peppapighs/HE8/HE8/HE8.kicad_pcb

## KiCad design HE8/HE8.kicad_pcb (2024-11-02)

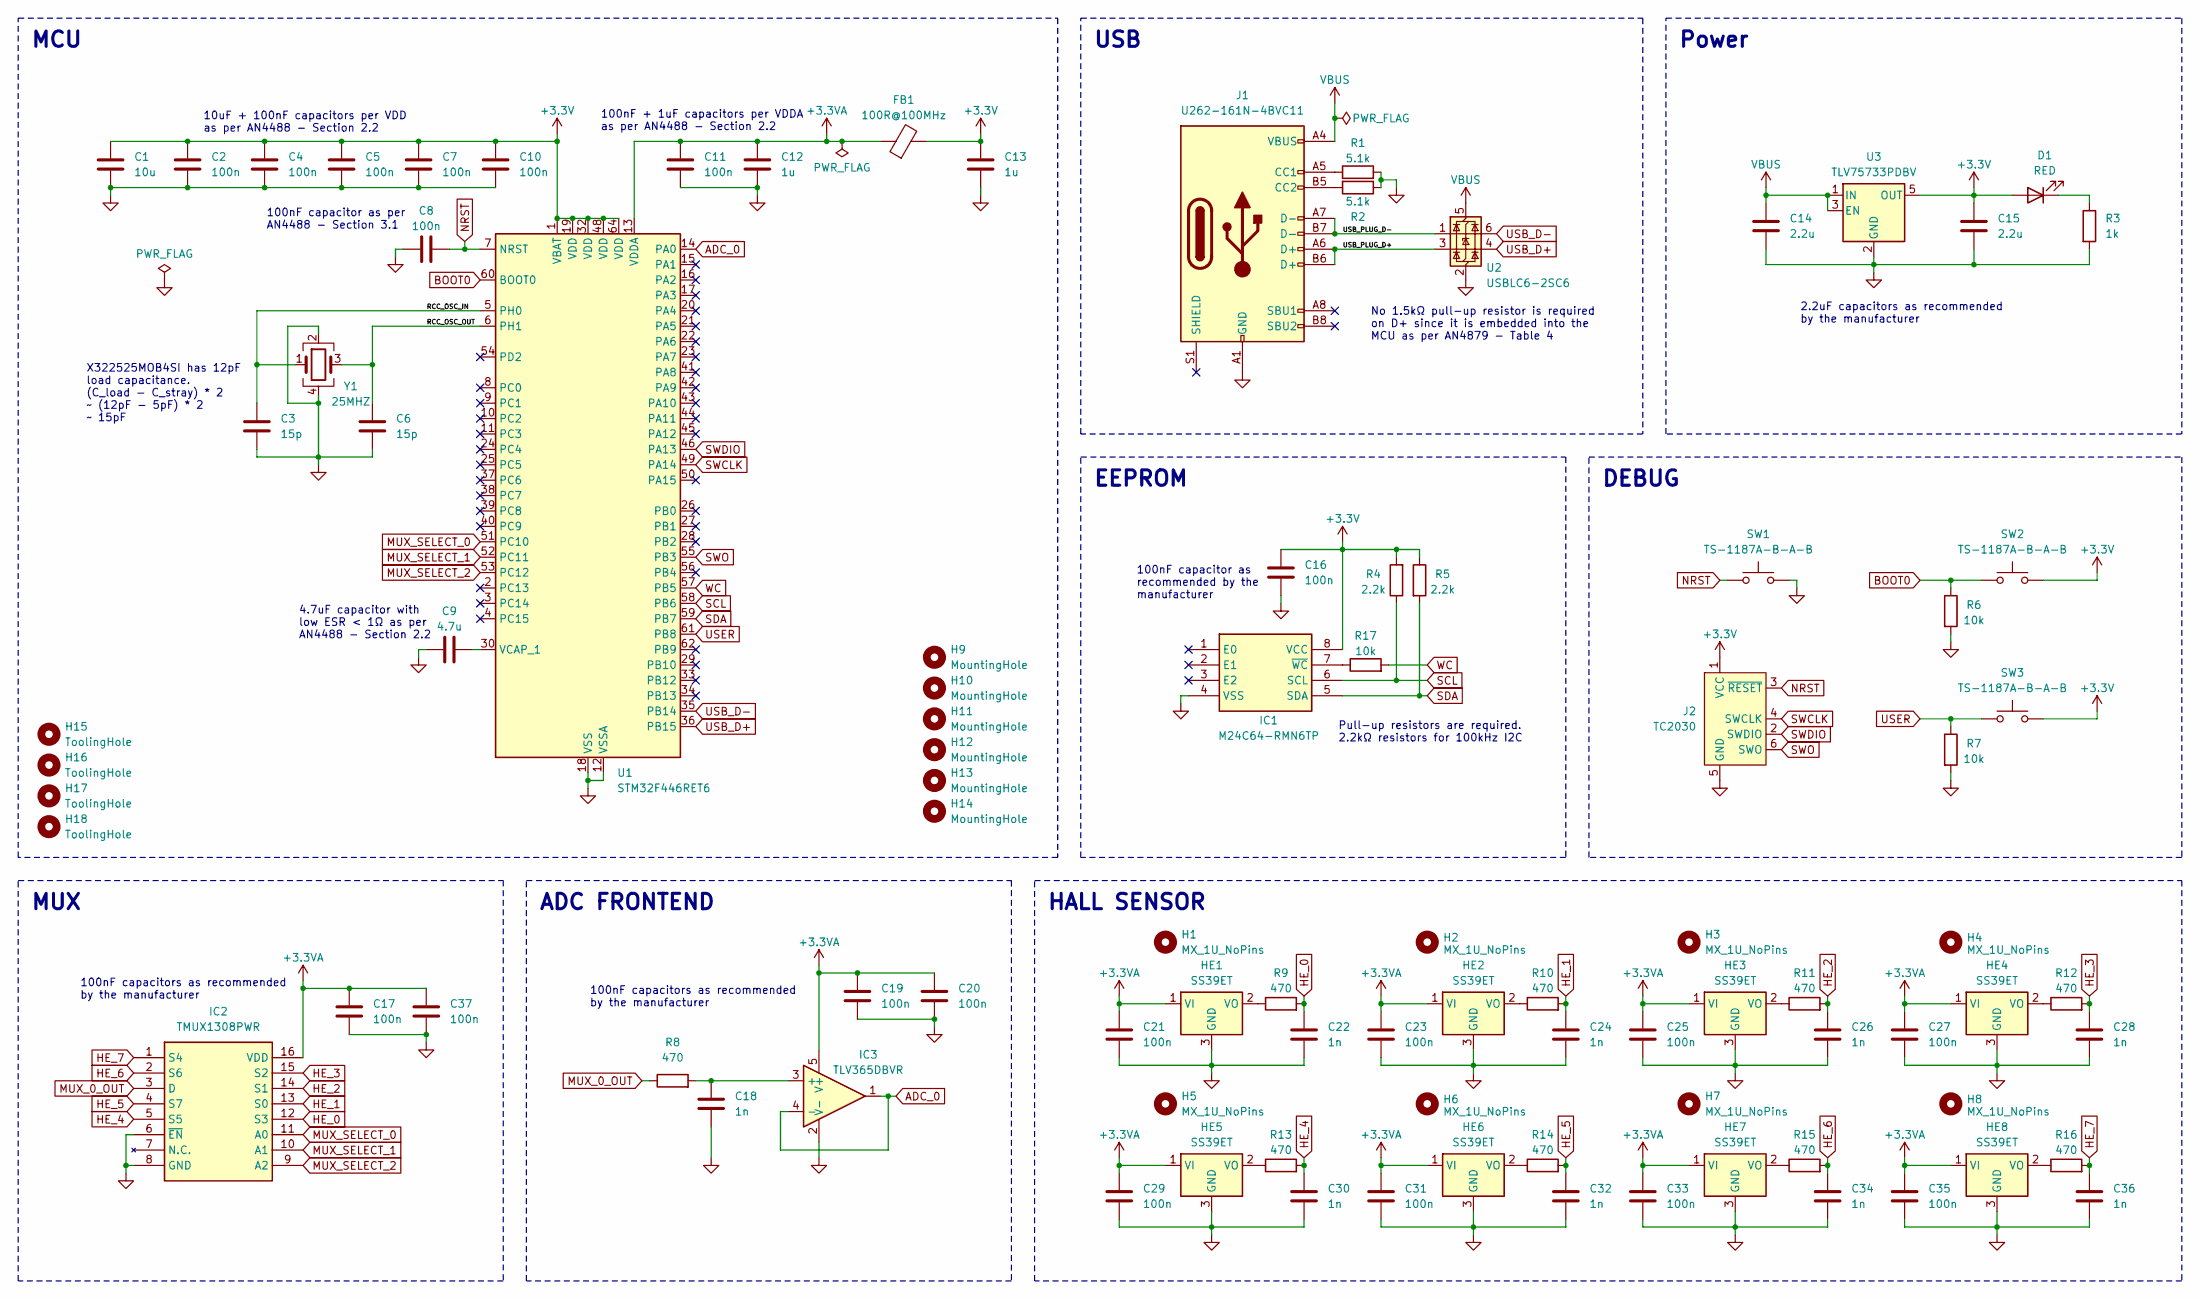
[picture p1: schematic HE8.kicad_sch]

Parts:
C1: 10u; C_0603_1608Metric
C2, C4, C5, C7, C8, C10, C11, C16, C17, C19, C20, C21, C23, C25, C27, C29, C31, C33, C35, C37: 100n; C_0402_1005Metric
C3, C6: 15p; C_0402_1005Metric
C9: 4.7u; C_0603_1608Metric
C12, C13: 1u; C_0603_1608Metric
C14, C15: 2.2u; C_0603_1608Metric
C18, C22, C24, C26, C28, C30, C32, C34, C36: 1n; C_0402_1005Metric
D1: RED; LED_0402_1005Metric
FB1: 100R@100MHz; L_0805_2012Metric
H1, H2, H3, H4, H5, H6, H7, H8: MX_1U_NoPins; MX-1U-NoPins
H9, H10, H11, H12, H13, H14: MountingHole; MountingHole_3.2mm_M3
H15, H16, H17, H18: ToolingHole
HE1, HE2, HE3, HE4, HE5, HE6, HE7, HE8: SS39ET; SOT95P280X140-3N; Mouser Part Number 785-SS39ET
IC1: M24C64-RMN6TP; SOIC127P600X175-8N; Mouser Part Number 511-M24C64-RMN6TP
IC2: TMUX1308PWR; SOP65P640X120-16N; Manufacturer_Part_Number TMUX1308PWR; Mouser Part Number 595-TMUX1308PWR
IC3: TLV365DBVR; SOT95P280X145-5N; Manufacturer_Part_Number TLV365DBVR
J1: U262-161N-4BVC11; USB_C_Receptacle_XKB_U262-16XN-4BVC11
J2: TC2030; Tag-Connect_TC2030-IDC-FP_2x03_P1.27mm_Vertical
R1, R2: 5.1k; R_0402_1005Metric
R3: 1k; R_0402_1005Metric
R4, R5: 2.2k; R_0402_1005Metric
R6, R7, R17: 10k; R_0402_1005Metric
R8, R9, R10, R11, R12, R13, R14, R15, R16: 470; R_0402_1005Metric
SW1, SW2, SW3: TS-1187A-B-A-B; SW_Push_1P1T_XKB_TS-1187A
U1: STM32F446RET6; LQFP-64_10x10mm_P0.5mm
U2: USBLC6-2SC6; SOT-23-6
U3: TLV75733PDBV; SOT-23-5
Y1: 25MHZ; Crystal_SMD_3225-4Pin_3.2x2.5mm

Connections:
+3.3V: C1.1, C2.1, C4.1, C5.1, C7.1, C10.1, C13.1, C15.1, C16.1, D1.2 (A), FB1.2, IC1.8 (VCC), J2.1 (VCC), R4.2, R5.1, SW2.2, SW3.2, U1.1 (VBAT), U1.19 (VDD), U1.32 (VDD), U1.48 (VDD), U1.64 (VDD), U3.5 (OUT)
+3.3VA: C11.1, C12.1, C17.1, C19.1, C20.1, C21.1, C23.1, C25.1, C27.1, C29.1, C31.1, C33.1, C35.1, C37.1, FB1.1, HE1.1 (VI), HE2.1 (VI), HE3.1 (VI), HE4.1 (VI), HE5.1 (VI), HE6.1 (VI), HE7.1 (VI), HE8.1 (VI), IC2.16 (VDD), IC3.5 (V+), U1.13 (VDDA)
/RCC_OSC_IN: C3.1, U1.5 (PH0), Y1.1
/RCC_OSC_OUT: C6.1, U1.6 (PH1), Y1.3
/USB_PLUG_D+: J1.A6 (D+), J1.B6 (D+), U2.3 (I/O2)
/USB_PLUG_D-: J1.A7 (D-), J1.B7 (D-), U2.1 (I/O1)
ADC_0: IC3.1, IC3.4 (-), U1.14 (PA0)
BOOT0: R6.1, SW2.1, U1.60 (BOOT0)
GND: C1.2, C2.2, C3.2, C4.2, C5.2, C6.2, C7.2, C8.1, C9.1, C10.2, C11.2, C12.2, C13.2, C14.2, C15.2, C16.2, C17.2, C18.2, C19.2, C20.2, C21.2, C22.2, C23.2, C24.2, C25.2, C26.2, C27.2, C28.2, C29.2, C30.2, C31.2, C32.2, C33.2, C34.2, C35.2, C36.2, C37.2, HE1.3 (GND), HE2.3 (GND), HE3.3 (GND), HE4.3 (GND), HE5.3 (GND), HE6.3 (GND), HE7.3 (GND), HE8.3 (GND), IC1.4 (VSS), IC2.6 (~EN), IC2.8 (GND), IC3.2 (V-), J1.A1 (GND), J1.A12 (GND), J1.B1 (GND), J1.B12 (GND), J2.5 (GND), R1.2, R2.1, R3.2, R6.2, R7.2, SW1.2, U1.12 (VSSA), U1.18 (VSS), U1.31 (VSS), U1.47 (VSS), U1.63 (VSS), U2.2 (GND), U3.2 (GND), Y1.2, Y1.4
HE_0: C22.1, IC2.12 (S3), R9.2
HE_1: C24.1, IC2.13 (S0), R10.2
HE_2: C26.1, IC2.14 (S1), R11.2
HE_3: C28.1, IC2.15 (S2), R12.2
HE_4: C30.1, IC2.5 (S5), R13.2
HE_5: C32.1, IC2.4 (S7), R14.2
HE_6: C34.1, IC2.2 (S6), R15.2
HE_7: C36.1, IC2.1 (S4), R16.2
MUX_0_OUT: IC2.3 (D), R8.1
MUX_SELECT_0: IC2.11 (A0), U1.51 (PC10)
MUX_SELECT_1: IC2.10 (A1), U1.52 (PC11)
MUX_SELECT_2: IC2.9 (A2), U1.53 (PC12)
NRST: C8.2, J2.3 (~RESET), SW1.1, U1.7 (NRST)
unnamed: D1.1 (K), R3.1
unnamed: HE1.2 (VO), R9.1
unnamed: HE2.2 (VO), R10.1
unnamed: HE3.2 (VO), R11.1
unnamed: HE4.2 (VO), R12.1
unnamed: HE5.2 (VO), R13.1
unnamed: HE6.2 (VO), R14.1
unnamed: HE7.2 (VO), R15.1
unnamed: HE8.2 (VO), R16.1
unnamed: IC1.7 (~WC), R17.1
unnamed: C18.1, IC3.3 (+), R8.2
unnamed: J1.A5 (CC1), R1.1
unnamed: J1.B5 (CC2), R2.2
unnamed: C9.2, U1.30 (VCAP_1)
SCL: IC1.6 (SCL), R4.1, U1.58 (PB6)
SDA: IC1.5 (SDA), R5.2, U1.59 (PB7)
SWCLK: J2.4 (SWCLK), U1.49 (PA14)
SWDIO: J2.2 (SWDIO), U1.46 (PA13)
SWO: J2.6 (SWO), U1.55 (PB3)
USB_D+: U1.36 (PB15), U2.4 (I/O2)
USB_D-: U1.35 (PB14), U2.6 (I/O1)
USER: R7.1, SW3.1, U1.61 (PB8)
VBUS: C14.1, J1.A4 (VBUS), J1.A9 (VBUS), J1.B4 (VBUS), J1.B9 (VBUS), U2.5 (VBUS), U3.1 (IN), U3.3 (EN)
WC: R17.2, U1.57 (PB5)

Notes on the sheet:
USB
MCU
ADC FRONTEND
EEPROM
DEBUG
HALL SENSOR
Power
MUX
X322525MOB4SI has 12pF load capacitance. (C_load - C_stray) * 2 ~ (12pF - 5pF) * 2 ~ 15pF
100nF capacitor as per AN4488 - Section 3.1
4.7uF capacitor with low ESR < 1Ω as per AN4488 - Section 2.2
100nF + 1uF capacitors per VDDA as per AN4488 - Section 2.2
2.2uF capacitors as recommended by the manufacturer
100nF capacitors as recommended by the manufacturer
No 1.5kΩ pull-up resistor is required on D+ since it is embedded into the MCU as per AN4879 - Table 4
10uF + 100nF capacitors per VDD as per AN4488 - Section 2.2
Pull-up resistors are required. 2.2kΩ resistors for 100kHz I2C
100nF capacitor as recommended by the manufacturer

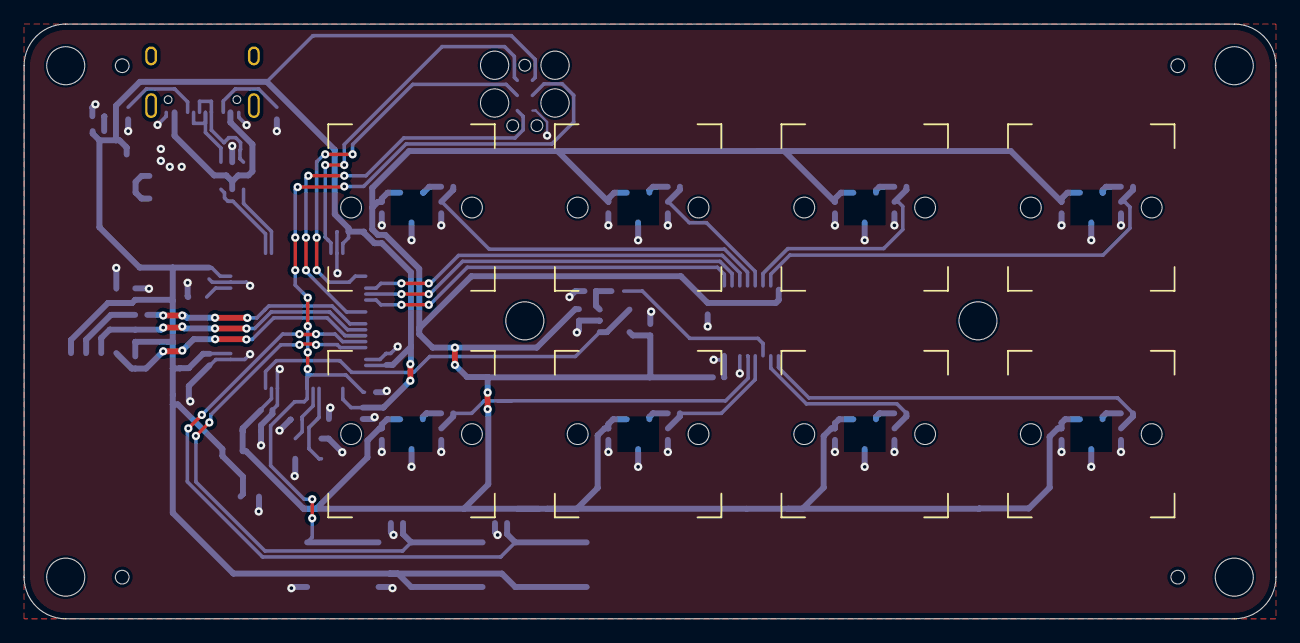
[picture p2: board HE8.kicad_pcb from above]

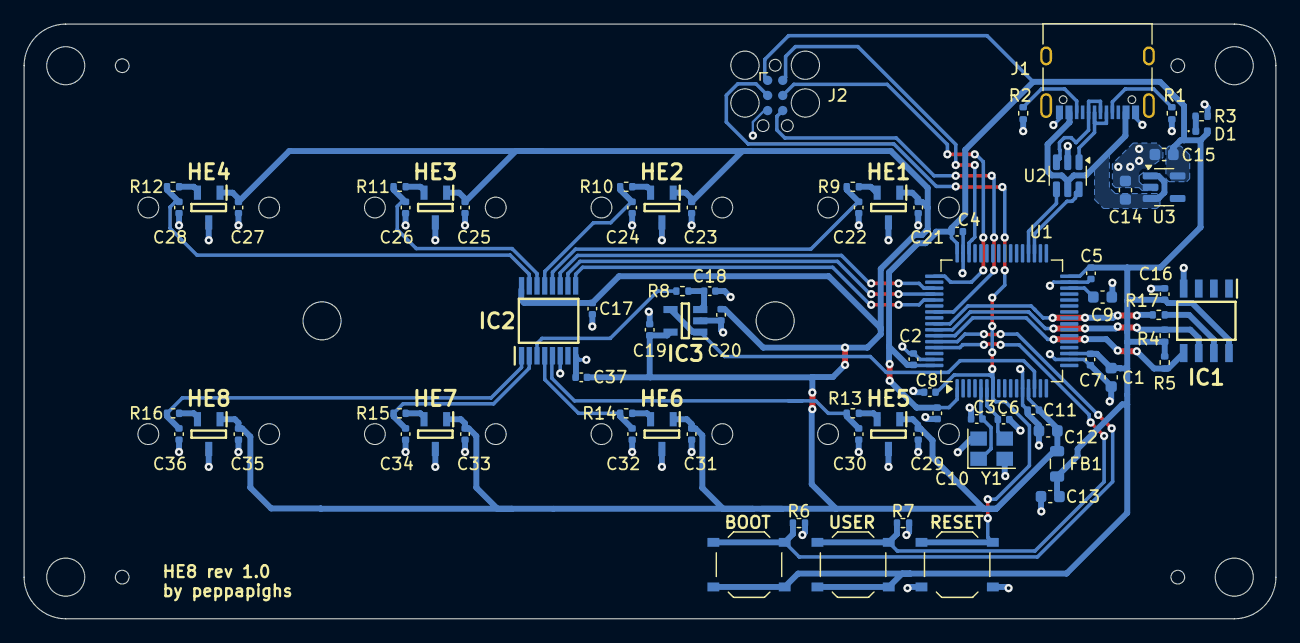
[picture p3: board HE8.kicad_pcb from below]

Board: 2 copper layers, 105.3 x 50.0 mm, 94 parts (82 on the bottom side), 46 nets.
