peppapighs/HE8/firmware/firmware.ioc

Mcu.UserName=STM32F446RETx
PA0-WKUP.Signal=ADCx_IN0
PA13.Signal=SYS_JTMS-SWDIO
PA14.Signal=SYS_JTCK-SWCLK
PB14.Signal=USB_OTG_HS_DM
PB15.Signal=USB_OTG_HS_DP
PB3.Signal=SYS_JTDO-SWO
PB5.GPIO_Label=WC
PB5.Signal=GPIO_Output
PB6.Signal=I2C1_SCL
PB7.Signal=I2C1_SDA
PB8.GPIO_Label=USER
PB8.Signal=GPIO_Input
PC10.GPIO_Label=MUX_SELECT_0
PC10.Signal=GPIO_Output
PC11.GPIO_Label=MUX_SELECT_1
PC11.Signal=GPIO_Output
PC12.GPIO_Label=MUX_SELECT_2
PC12.Signal=GPIO_Output
PH0-OSC_IN.Signal=RCC_OSC_IN
PH1-OSC_OUT.Signal=RCC_OSC_OUT
