peppapighs/HE8/firmware/Core/Inc/main.h

#define MUX_SELECT_0_Pin GPIO_PIN_10
#define MUX_SELECT_0_GPIO_Port GPIOC
#define MUX_SELECT_1_Pin GPIO_PIN_11
#define MUX_SELECT_1_GPIO_Port GPIOC
#define MUX_SELECT_2_Pin GPIO_PIN_12
#define MUX_SELECT_2_GPIO_Port GPIOC
#define WC_Pin GPIO_PIN_5
#define WC_GPIO_Port GPIOB
#define USER_Pin GPIO_PIN_8
#define USER_GPIO_Port GPIOB
