peppapighs/HE8/firmware/Core/Inc/tusb_config.h

/*
 * tusb_config.h
 *
 *  Created on: Nov 4, 2024
 *      Author: Pep
 */

#ifndef INC_TUSB_CONFIG_H_
#define INC_TUSB_CONFIG_H_

//--------------------------------------------------------------------+
// Board Specific Configuration
//--------------------------------------------------------------------+

#define CFG_TUSB_MCU OPT_MCU_STM32F4
#define CFG_TUSB_RHPORT1_MODE (OPT_MODE_DEVICE | OPT_MODE_FULL_SPEED)

// RHPort number used for device
#define BOARD_TUD_RHPORT 1

// RHPort max operational speed can defined by board.mk
#ifndef BOARD_TUD_MAX_SPEED
#define BOARD_TUD_MAX_SPEED OPT_MODE_DEFAULT_SPEED
#endif

//--------------------------------------------------------------------
// COMMON CONFIGURATION
//--------------------------------------------------------------------

// defined by compiler flags for flexibility
#ifndef CFG_TUSB_MCU
#error CFG_TUSB_MCU must be defined
#endif

#ifndef CFG_TUSB_OS
#define CFG_TUSB_OS OPT_OS_NONE
#endif

#ifndef CFG_TUSB_DEBUG
#define CFG_TUSB_DEBUG 0
#endif

// Enable Device stack
#define CFG_TUD_ENABLED 1

// Default is max speed that hardware controller could support with on-chip PHY
#define CFG_TUD_MAX_SPEED BOARD_TUD_MAX_SPEED

/* USB DMA on some MCUs can only access a specific SRAM region with restriction
 * on alignment. Tinyusb use follows macros to declare transferring memory so
 * that they can be put into those specific section. e.g
 * - CFG_TUSB_MEM SECTION : __attribute__ (( section(".usb_ram") ))
 * - CFG_TUSB_MEM_ALIGN   : __attribute__ ((aligned(4)))
 */
#ifndef CFG_TUSB_MEM_SECTION
#define CFG_TUSB_MEM_SECTION
#endif

#ifndef CFG_TUSB_MEM_ALIGN
#define CFG_TUSB_MEM_ALIGN __attribute__((aligned(4)))
#endif

//--------------------------------------------------------------------
// DEVICE CONFIGURATION
//--------------------------------------------------------------------

#ifndef CFG_TUD_ENDPOINT0_SIZE
#define CFG_TUD_ENDPOINT0_SIZE 64
#endif

//------------- CLASS -------------//
#define CFG_TUD_HID 1
#define CFG_TUD_VENDOR 1

// HID buffer size Should be sufficient to hold ID (if any) + Data
#define CFG_TUD_HID_EP_BUFSIZE 64

_Static_assert(CFG_TUD_HID_EP_BUFSIZE >= 16,
               "Buffer size must be at least 16 bytes");

#endif /* INC_TUSB_CONFIG_H_ */
