peppapighs/HE8/firmware/Core/Src/keyboard.c

/*
 * keyboard.h
 *
 *  Created on: Nov 13, 2024
 *      Author: Pep
 */

#include "keyboard.h"

#include <memory.h>
#include <stdbool.h>

#include "eeprom.h"
#include "keyboard_config.h"
#include "main.h"

//--------------------------------------------------------------------+
// Keyboard Configuration
//--------------------------------------------------------------------+

switch_profile_t const switch_profiles[SWITCH_PROF_COUNT] = {
    [SWITCH_PROF_GEON_RAW_HE] =
        {
            .travel_distance = 340,
            .adc_rest_value = 1700,
            .adc_offset = 700,
        },
    [SWITCH_PROF_GATERON_MAGNETIC_JADE] =
        {
            .travel_distance = 350,
            .adc_rest_value = 1700,
            .adc_offset = 700,
        },
    [SWITCH_PROF_WOOTING_LEKKER] =
        {
            .travel_distance = 400,
            .adc_rest_value = 1700,
            .adc_offset = 700,
        },
    [SWITCH_PROF_GATERON_KS_20] =
        {
            .travel_distance = 410,
            .adc_rest_value = 1700,
            .adc_offset = 700,
        },
};

uint16_t const distance_table[DISTANCE_TABLE_GRAIN + 1] = {
    1024, 1023, 1023, 1022, 1021, 1021, 1020, 1019, 1019, 1018, 1017, 1017,
    1016, 1015, 1015, 1014, 1013, 1013, 1012, 1011, 1011, 1010, 1009, 1009,
    1008, 1007, 1007, 1006, 1005, 1005, 1004, 1003, 1003, 1002, 1001, 1001,
    1000, 999,  999,  998,  997,  996,  996,  995,  994,  994,  993,  992,
    992,  991,  990,  990,  989,  988,  988,  987,  986,  986,  985,  984,
    984,  983,  982,  982,  981,  980,  980,  979,  978,  977,  977,  976,
    975,  975,  974,  973,  973,  972,  971,  971,  970,  969,  969,  968,
    967,  967,  966,  965,  964,  964,  963,  962,  962,  961,  960,  960,
    959,  958,  958,  957,  956,  956,  955,  954,  953,  953,  952,  951,
    951,  950,  949,  949,  948,  947,  947,  946,  945,  944,  944,  943,
    942,  942,  941,  940,  940,  939,  938,  937,  937,  936,  935,  935,
    934,  933,  933,  932,  931,  930,  930,  929,  928,  928,  927,  926,
    926,  925,  924,  923,  923,  922,  921,  921,  920,  919,  919,  918,
    917,  916,  916,  915,  914,  914,  913,  912,  912,  911,  910,  909,
    909,  908,  907,  907,  906,  905,  904,  904,  903,  902,  902,  901,
    900,  899,  899,  898,  897,  897,  896,  895,  894,  894,  893,  892,
    892,  891,  890,  889,  889,  888,  887,  887,  886,  885,  884,  884,
    883,  882,  882,  881,  880,  879,  879,  878,  877,  877,  876,  875,
    874,  874,  873,  872,  872,  871,  870,  869,  869,  868,  867,  866,
    866,  865,  864,  864,  863,  862,  861,  861,  860,  859,  858,  858,
    857,  856,  856,  855,  854,  853,  853,  852,  851,  850,  850,  849,
    848,  847,  847,  846,  845,  845,  844,  843,  842,  842,  841,  840,
    839,  839,  838,  837,  836,  836,  835,  834,  834,  833,  832,  831,
    831,  830,  829,  828,  828,  827,  826,  825,  825,  824,  823,  822,
    822,  821,  820,  819,  819,  818,  817,  816,  816,  815,  814,  813,
    813,  812,  811,  810,  810,  809,  808,  807,  807,  806,  805,  804,
    804,  803,  802,  801,  801,  800,  799,  798,  798,  797,  796,  795,
    795,  794,  793,  792,  792,  791,  790,  789,  789,  788,  787,  786,
    786,  785,  784,  783,  782,  782,  781,  780,  779,  779,  778,  777,
    776,  776,  775,  774,  773,  773,  772,  771,  770,  769,  769,  768,
    767,  766,  766,  765,  764,  763,  763,  762,  761,  760,  759,  759,
    758,  757,  756,  756,  755,  754,  753,  752,  752,  751,  750,  749,
    749,  748,  747,  746,  745,  745,  744,  743,  742,  742,  741,  740,
    739,  738,  738,  737,  736,  735,  734,  734,  733,  732,  731,  731,
    730,  729,  728,  727,  727,  726,  725,  724,  723,  723,  722,  721,
    720,  719,  719,  718,  717,  716,  715,  715,  714,  713,  712,  711,
    711,  710,  709,  708,  707,  707,  706,  705,  704,  703,  703,  702,
    701,  700,  699,  699,  698,  697,  696,  695,  695,  694,  693,  692,
    691,  690,  690,  689,  688,  687,  686,  686,  685,  684,  683,  682,
    682,  681,  680,  679,  678,  677,  677,  676,  675,  674,  673,  673,
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
};

keyboard_config_t keyboard_config;

//--------------------------------------------------------------------+
// Configuration Functions
//--------------------------------------------------------------------+

// Get the end of stack address from the linker script to load the boot flag
extern const uint32_t _estack;

void reboot_to_bootloader(void) {
  uint32_t *boot_flag = (uint32_t *)&_estack;

  // Set the boot flag to the magic value
  *boot_flag = BOOT_FLAG;
  NVIC_SystemReset();
}

void load_keyboard_config(void) {
  uint32_t magic = 0;
  uint16_t version = 0;

  // Load default configuration
  memcpy(&keyboard_config, &default_keyboard_config, sizeof(keyboard_config));

  // Read the magic and version from EEPROM
  eeprom_read(offsetof(keyboard_config_t, magic), (uint8_t *)&magic,
              sizeof(magic));
  eeprom_read(offsetof(keyboard_config_t, version), (uint8_t *)&version,
              sizeof(version));

  if (magic != FIRMWARE_MAGIC) {
    // Set default configuration
    save_keyboard_config();
  } else if (version != FIRMWARE_VERSION) {
    // FIXME: Handle version migration
    save_keyboard_config();
  } else {
    eeprom_read(0, (uint8_t *)&keyboard_config, sizeof(keyboard_config));
  }
}

void save_keyboard_config(void) {
  eeprom_write(0, (uint8_t *)&keyboard_config, sizeof(keyboard_config));
}

void factory_reset(void) {
  memcpy(&keyboard_config, &default_keyboard_config, sizeof(keyboard_config));

  save_keyboard_config();
}

void save_key_switch_config(uint8_t profile, uint8_t key_index) {
  eeprom_write(
      offsetof(keyboard_config_t, key_switch_config) +
          ((uint32_t)profile * NUM_KEYS + key_index) *
              sizeof(key_switch_config_t),
      (uint8_t *)&keyboard_config.key_switch_config[profile][key_index],
      sizeof(keyboard_config.key_switch_config[profile][key_index]));
}

void save_keymap(uint8_t profile, uint8_t layer, uint8_t key_index) {
  eeprom_write(
      offsetof(keyboard_config_t, key_switch_config) +
          (((uint32_t)profile * NUM_LAYERS + layer) * NUM_KEYS + key_index) *
              sizeof(uint16_t),
      (uint8_t *)&keyboard_config.keymap[profile][layer][key_index],
      sizeof(keyboard_config.keymap[profile][layer][key_index]));
}

void set_nkro(bool nkro) {
  keyboard_config.nkro = nkro;

  // Save the new NKRO setting
  eeprom_write(offsetof(keyboard_config_t, nkro),
               (uint8_t *)&keyboard_config.nkro, sizeof(keyboard_config.nkro));
}

void set_switch_profile(uint8_t profile) {
  // Check if the profile is valid
  if (profile >= SWITCH_PROF_COUNT)
    return;

  keyboard_config.switch_profile = profile;

  // Save the new switch profile
  eeprom_write(offsetof(keyboard_config_t, switch_profile),
               (uint8_t *)&keyboard_config.switch_profile,
               sizeof(keyboard_config.switch_profile));
}

void set_keyboard_profile(uint8_t profile) {
  // Check if the profile is valid
  if (profile >= NUM_PROFILES)
    return;

  keyboard_config.keyboard_profile = profile;

  // Save the new keymap profile
  eeprom_write(offsetof(keyboard_config_t, keyboard_profile),
               (uint8_t *)&keyboard_config.keyboard_profile,
               sizeof(keyboard_config.keyboard_profile));
}
