peppapighs/HE8/firmware/Core/Src/hid.c

/*
 * hid.c
 *
 *  Created on: Nov 15, 2024
 *      Author: Pep
 */

#include "firmware.h"
#include "usb_descriptors.h"

//--------------------------------------------------------------------+
// HID Related Callbacks
//--------------------------------------------------------------------+

// Invoked when received GET_REPORT control request
// Application must fill buffer report's content and return its length.
// Return zero will cause the stack to STALL request
uint16_t tud_hid_get_report_cb(uint8_t instance, uint8_t report_id,
                               hid_report_type_t report_type, uint8_t *buffer,
                               uint16_t reqlen) {
  return 0;
}

// Invoked when received SET_REPORT control request or
// received data on OUT endpoint ( Report ID = 0, Type = 0 )
void tud_hid_set_report_cb(uint8_t instance, uint8_t report_id,
                           hid_report_type_t report_type, uint8_t const *buffer,
                           uint16_t bufsize) {}

// Invoked when sent REPORT successfully to host
// Application can use this to send the next report
// Note: For composite reports, report[0] is report ID
void tud_hid_report_complete_cb(uint8_t instance, uint8_t const *report,
                                uint16_t len) {
  for (uint8_t i = report[0] + 1; i < REPORT_ID_COUNT; i++) {
    if (i == REPORT_ID_KB_NKRO)
      // If NKRO is disabled, skip the NKRO report
      continue;
    if (send_hid_report(i))
      return;
  }
}
