peppapighs/HE8/firmware/Core/Src/keycodes.c

/*
 * keycodes.c
 *
 *  Created on: Nov 12, 2024
 *      Author: Pep
 */

#include "keycodes.h"

#include "tusb.h"

//--------------------------------------------------------------------+
// Keycode Conversion Functions
//--------------------------------------------------------------------+

uint16_t keycode_to_system_control(uint16_t keycode) {
  switch (keycode) {
  case KC_PWR:
    return HID_USAGE_DESKTOP_SYSTEM_POWER_DOWN;
  case KC_WAKE:
    return HID_USAGE_DESKTOP_SYSTEM_WAKE_UP;
  case KC_SLEP:
    return HID_USAGE_DESKTOP_SYSTEM_SLEEP;

  default:
    return KC_NO;
  }
}

uint16_t keycode_to_consumer_control(uint16_t keycode) {
  switch (keycode) {
  case KC_BRIU:
    return HID_USAGE_CONSUMER_BRIGHTNESS_INCREMENT;
  case KC_BRID:
    return HID_USAGE_CONSUMER_BRIGHTNESS_DECREMENT;
  case KC_MPLY:
    return HID_USAGE_CONSUMER_PLAY_PAUSE;
  case KC_MNXT:
    return HID_USAGE_CONSUMER_SCAN_NEXT;
  case KC_MPRV:
    return HID_USAGE_CONSUMER_SCAN_PREVIOUS;
  case KC_MSTP:
    return HID_USAGE_CONSUMER_STOP;
  case KC_MUTE:
    return HID_USAGE_CONSUMER_MUTE;
  case KC_VOLU:
    return HID_USAGE_CONSUMER_VOLUME_INCREMENT;
  case KC_VOLD:
    return HID_USAGE_CONSUMER_VOLUME_DECREMENT;
  case KC_MSEL:
    return HID_USAGE_CONSUMER_AL_CONSUMER_CONTROL_CONFIGURATION;
  case KC_MAIL:
    return HID_USAGE_CONSUMER_AL_EMAIL_READER;
  case KC_CALC:
    return HID_USAGE_CONSUMER_AL_CALCULATOR;
  case KC_MYCM:
    return HID_USAGE_CONSUMER_AL_LOCAL_BROWSER;
  case KC_WSCH:
    return HID_USAGE_CONSUMER_AC_SEARCH;
  case KC_WHOM:
    return HID_USAGE_CONSUMER_AC_HOME;
  case KC_WBAK:
    return HID_USAGE_CONSUMER_AC_BACK;
  case KC_WFWD:
    return HID_USAGE_CONSUMER_AC_FORWARD;
  case KC_WSTP:
    return HID_USAGE_CONSUMER_AC_STOP;
  case KC_WREF:
    return HID_USAGE_CONSUMER_AC_REFRESH;
  case KC_WFAV:
    return HID_USAGE_CONSUMER_AC_BOOKMARKS;
  case KC_EJCT:
    return 0x00CC;
  case KC_MFFD:
    return 0x00B3;
  case KC_MRWD:
    return 0x00B4;
  case KC_CPNL:
    return 0x019F;
  case KC_ASST:
    return 0x01CB;
  case KC_MCTL:
    return 0x029F;
  case KC_LPAD:
    return 0x02A0;

  default:
    return KC_NO;
  }
}

uint8_t keycode_to_modifier(uint16_t keycode) {
  return 1 << (keycode & 0x000F);
}
