peppapighs/HE8/bootloader/Core/Inc/bootloader.h

/*
 * bootloader.h
 *
 *  Created on: Nov 3, 2024
 *      Author: Pep
 */

#ifndef INC_BOOTLOADER_H_
#define INC_BOOTLOADER_H_

//--------------------------------------------------------------------+
// Bootloader Functions
//--------------------------------------------------------------------+

// Bootloader initialization
void bootloader_init(void);

// Bootloader main loop
void bootloader_loop(void);

#endif /* INC_BOOTLOADER_H_ */
