peppapighs/HE8/(commit log)

2024-11-04 add plate arts
    [HE8_bottomplate.kicad_pcb, HE8_switchplate.kicad_pcb]
2024-11-06 add firmware checksum padding script & fix bootloader crc bug
    [bootloader.c, firmware_padding.py]
2024-11-06 fix integer overflow causing irratic adc readings
    [firmware.c]
2024-11-10 digitally filter noise using exponential smoothing
    [firmware.c, firmware_config.h, keyboard.h, keyboard_config.h]
2024-11-11 use quadratic interpolation for more accurate switch distance
2024-11-12 fix keyboard not sending keycodes bug
    [firmware.c]
2024-11-13 fix one shot keys algorithm
    [firmware.c, firmware_config.h, keyboard_config.h]
2024-11-13 save config to eeprom & add profile switching
2024-11-13 refactor code & add switch profile switching
2024-11-14 fix one-time key bug
    [firmware.c, keyboard_config.c, keycodes.h]
2024-11-14 optimize key switch polling
2024-11-16 replace duplicates with aliases instead in keycodes
    [keycodes.h]
2024-11-18 add enum values for key switch state
